simple-circuit/CCDCameraCookbook/(threads)

Thread 1 (2025-09-29):

CCDCameraCookbook

pilonmj, 2025-09-29:
Hi

I am working on building your CCD camera cookbook circuit using a Teensy 4.0 interface for a TC245 Camera.

I notice in your cookbookUSB.pdf file that on page 5 the interface board schematic diagram has some differences from the final PCB board. For example C5 and C11 connections. Also, I cannot find a place for D4 or C6 on the PCB board (Page 7).

Finally I notice on page 9 your final board for a 245 camera includes a 2.2K resistor and a 2N222A - even though on page 12 the parts list indicates these are only needed for the TC211 Camera. Should I include these?

Thanks,

Mark
